codeshelf/CHECON.MECH/README.md

# CHECON.MECH
The mechanicals for the CHE controller
