codeshelf/CHECON.MECH/CHECON.MECH production files/CHECON.COVER/CHECON.COVER VER 1.1 REV B LASERCUT README.docx

CHECON.COVER VER 1.1 REV B LASERCUT README

For PONOKO

use file - P2X24 CHECON.COVER VER 1.1 REV B PRODUCTION.eps

material - CLEAR ACRYLIC

thickness - 0.118 inches

sheet size - p2

yield - 24
