codeshelf/CHECON.MECH/CHECON.MECH production files/CHECON.TRAY/CHECON.TRAY LASERCUT README VER 1.0 REV A.docx

CHECON.TRAY VER 1.0 REV A LASERCUT README

For PONOKO

use file - P2X24 CHECON.TRAY VER 1.0 REV A PRODUCTION.eps

material - CLEAR ACRYLIC

thickness - 0.060 inches

sheet size - p2

yield - 24
