codeshelf/CHECON.MECH/CHECON.MECH.BOM.xlsx

 | Product Name: | CHE Controller Mechanicals |  | Tag: | CHECON.MECH.v1.5 RC
 | Product Number: | CHECON.MECH |  | Date: | 2015-08-03
 |  |  |  | Last Updated: | 2015-08-03
Qty | Name | Description | Drawing/Part No. | Version | Date | Supplier | Link | Notes
1 | Top Coverplate | Machined Aluminum Part | CHECON.FACE | VER 1.1 REV B |  | Mean Machine Inc.
1 | Screen Coverplate Top | Lasercut Acrylic Screen Cover | CHECON.COVER | VER 1.1 REV B |  | Ponoko
1 | Screen Coverplate Bottom | Lasercut Acrylic Screen alignment tray | CHECON.TRAY | VER 1.0 REV A |  | Ponoko
1 | Zero Screw Core | Lasercut and/or Machined Delrin Part | CHECON.CORETOP | VER 1.0 REV A |  | Mean Machine Inc.
1 | Four Screw Core B | Delrin Shell Part, Top | CHECON.COREMID | VER 1.1 REV B |  | Mean Machine Inc.
1 | Four Screw Core A | Delrin Shell Part, Bottom | CHECON.COREBOT | VER 1.1 REV B |  | Mean Machine Inc.
1 | Bottom Coverplate | Lasercut 6061 1/16" Aluminum Sheet | CHECON.BACK | VER 1.1 REV B |  | Mean Machine Inc.
2 | PEM Cold-Pressed Stud | McMaster PN 93580A220 18-8 SS, 6-32 thread, 0.5" long | 93580A220 |  |  | McMaster-Carr | http://www.mcmaster.com/#catalog/121/3178/=x1v7sd
n/a | Delrin (acetal resin), black, 0.25” thick | Feedstock
n/a | 6061 Aluminum sheet, 1/16” thick | Feedstock
n/a | Clear Acrylic, 0.060” thick | Feedstock
n/a | Clear Acrylic, 0.118” thick | Feedstock
