codeshelf/CHECON.MECH/CHECON.MECH design files/CHECON.MECH packngo/S181FL-6-RMM-2450S.SLDASM

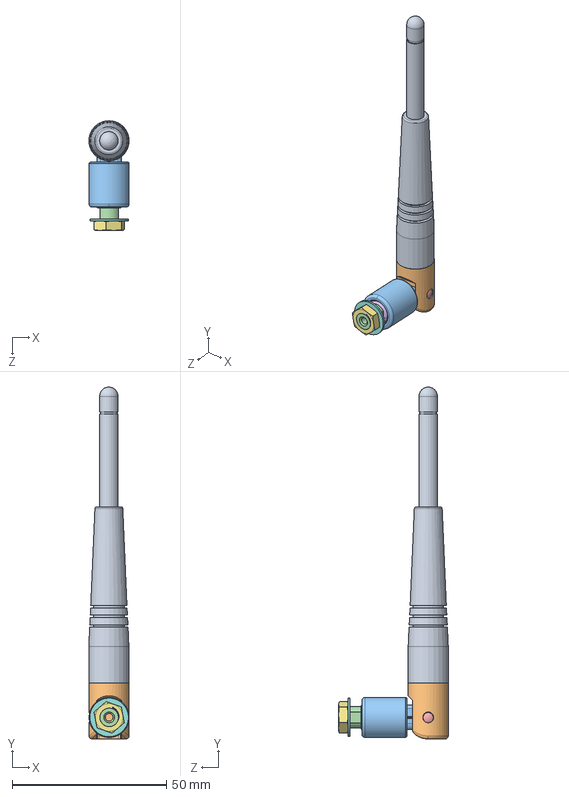
[picture p1: CAD file, 2015-04-10]
CHECON.MECH design files/CHECON.MECH packngo/S181FL-6-RMM-2450S.SLDASM
13.1 x 114.0 x 35.5 mm
03075B0000_REV.04_IW-144&151¤U©T©w®y
01391B0001(REV.01)
01257B0000-³s±µ¤l(IW-144)(REV03) x 2
09010B0000
01375N0000
02021Z0001
