codeshelf/CHECON.MECH/CHECON.MECH design files/CHECON.MECH packngo/CHE Backplate Assy.sldasm

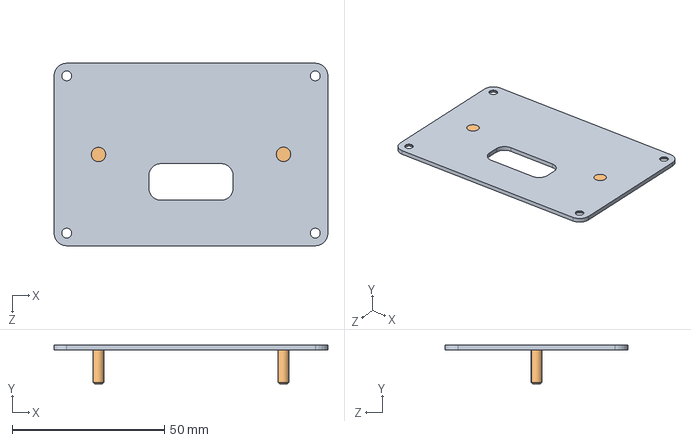
[picture p2: CAD file, 2015-04-10]
CHECON.MECH design files/CHECON.MECH packngo/CHE Backplate Assy.sldasm
90.0 x 12.7 x 60.0 mm
CHE Backplate
