codeshelf/CHECON.MECH/CHECON.MECH design files/CHECON.MECH packngo/CHECON.MECH full assembly.SLDASM

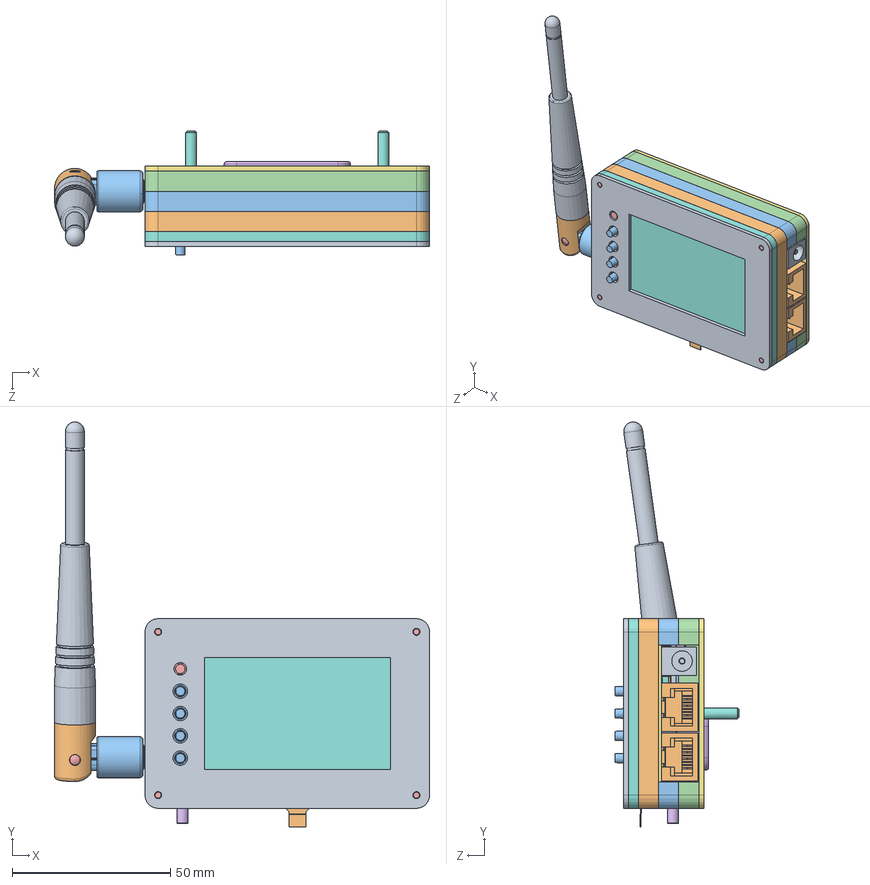
[picture p3: CAD file, 2015-04-10]
CHECON.MECH design files/CHECON.MECH packngo/CHECON.MECH full assembly.SLDASM
118.6 x 128.1 x 39.2 mm
CHE Coverplate
CHE 0 Screw Core
CHE 4 Screw Core Quarter Inch B
CHE 4 Screw Core Quarter Inch A
91771A115 x 4
heyco-2968
CHE Backplate
BrainPCB
DF12(3.0)-40DS-0.5V_1
Part1^03 BrainPCBAssembly
MMCX_Connector
93135A275 x 2
94900A005
02 CHEDaughterPCB
DF12(3.0)-40DP-0.5V
PJ-002A_Barrel
955016889_RJ45 x 2
TL3301DFxxxxG-13mm x 4
AAA3528
VLP-400-F
c-2-1825027-0-g1-3d_RA_Button
JTAG Header
Screen Coverplate Top Rev. B
Screen Coverplate Bottom
Rear POL
Front POL
LCD glass
Screen Spacer
03075B0000_REV.04_IW-144&151¤U©T©w®y
01391B0001(REV.01)
01257B0000-³s±µ¤l(IW-144)(REV03) x 2
09010B0000
01375N0000
02021Z0001
