codeshelf/CHECON.MECH/CHECON.MECH design files/CHECON.MECH packngo/02 LEDElectronicsAssembly.SLDASM

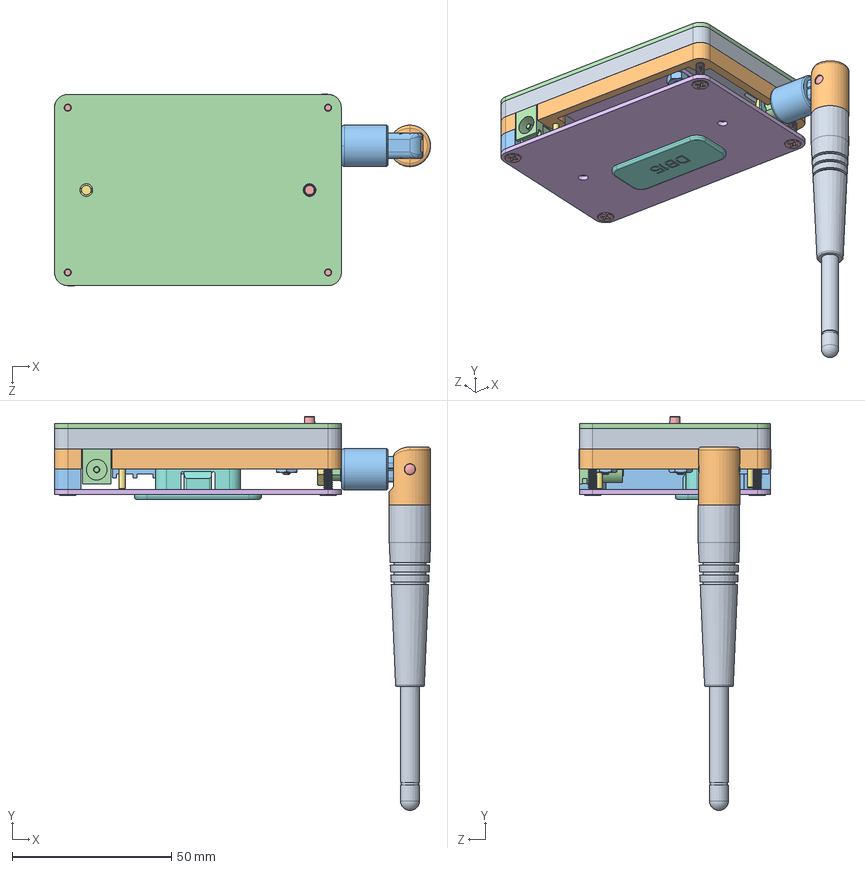
[picture p4: CAD file, 2015-04-10]
CHECON.MECH design files/CHECON.MECH packngo/02 LEDElectronicsAssembly.SLDASM
118.0 x 123.6 x 60.1 mm
02.1 LEDDaughterPCB
DF12(3.0)-40DP-0.5V
c-0350944-10-n-3d_Mate-n-lok
PJ-002A_Barrel
TL3301PFxxxxG_Button
AAA3528
VLP-200-F
91735A145 x 2
90480A007 x 2
93135A275 x 2
94900A005 x 2
JTAG Header
MMCX_Connector
BrainPCB
DF12(3.0)-40DS-0.5V_1
Part1^03 BrainPCBAssembly
LED 0 Screw Core
LED 4 Screw Core Quarter Inch B
LEDCON.CORESIDE
Top Coverplate
Flat Head Machine Screw Seven Eights x 4
00 LED Bottom Coverplate
93600A082 Dowel Pin 2mmx18mm x 2
heyco-2968
03075B0000_REV.04_IW-144&151¤U©T©w®y
01391B0001(REV.01)
01257B0000-³s±µ¤l(IW-144)(REV03) x 2
09010B0000
01375N0000
02021Z0001
