codeshelf/CHECON.MECH/CHECON.MECH design files/CHECON.MECH packngo/Daughter to Brain Connector DF12(3.0)-40DS-0.5V.SLDASM

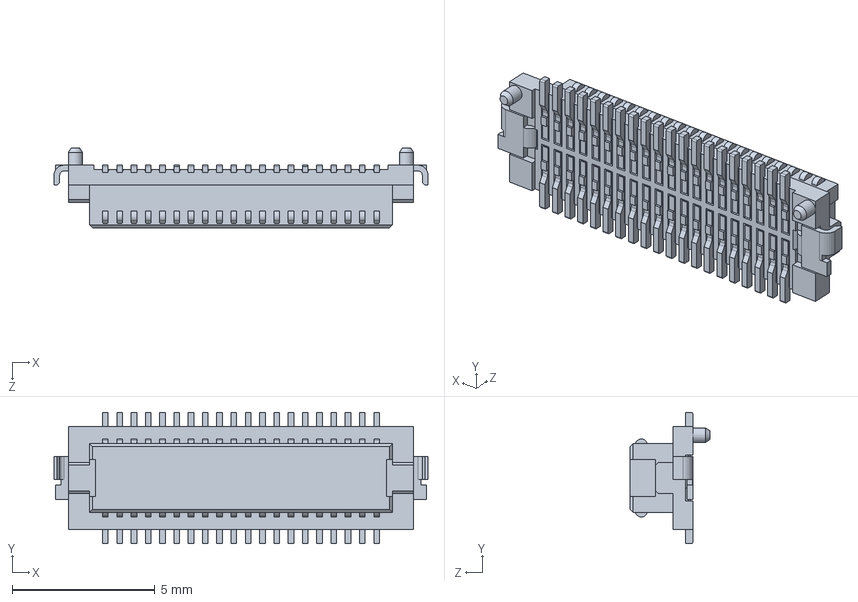
[picture p5: CAD file, 2015-04-10]
CHECON.MECH design files/CHECON.MECH packngo/Daughter to Brain Connector DF12(3.0)-40DS-0.5V.SLDASM
13.1 x 4.60 x 2.80 mm
