codeshelf/CHECON.MECH/CHECON.MECH production files/CHECON.COREBOT/CHECON.COREBOT VER 1.1 REV B.STEP

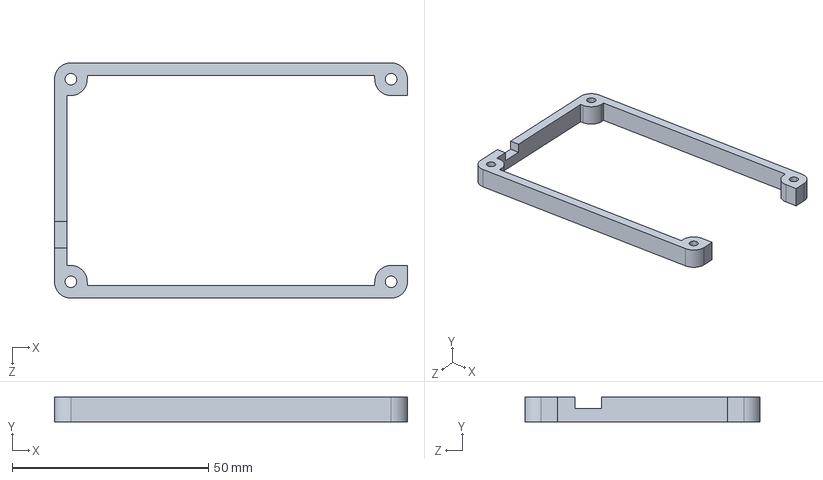
[picture p6: CAD file, 2015-07-16]
CHECON.MECH production files/CHECON.COREBOT/CHECON.COREBOT VER 1.1 REV B.STEP
90.0 x 6.35 x 60.0 mm
