codeshelf/CHECON.MECH/CHECON.MECH production files/CHECON.CORETOP/CHECON.CORETOP VER 1.0 REV A.STEP

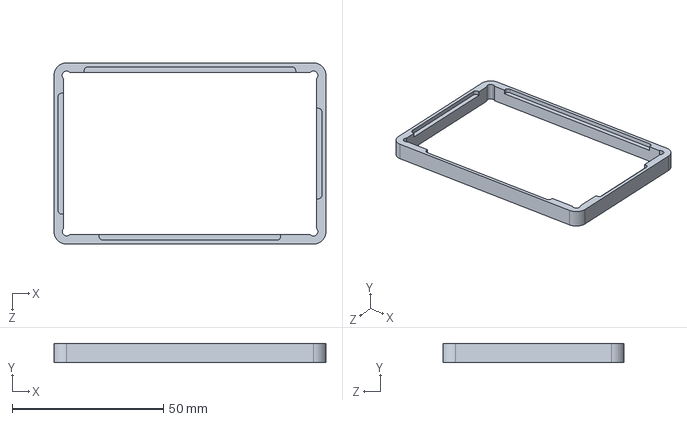
[picture p7: CAD file, 2015-04-10]
CHECON.MECH production files/CHECON.CORETOP/CHECON.CORETOP VER 1.0 REV A.STEP
90.0 x 6.35 x 60.0 mm
