codeshelf/CHECON.MECH/CHECON.MECH production files/CHECON.FACE/CHECON.FACE VER 1.1 REV B.STEP

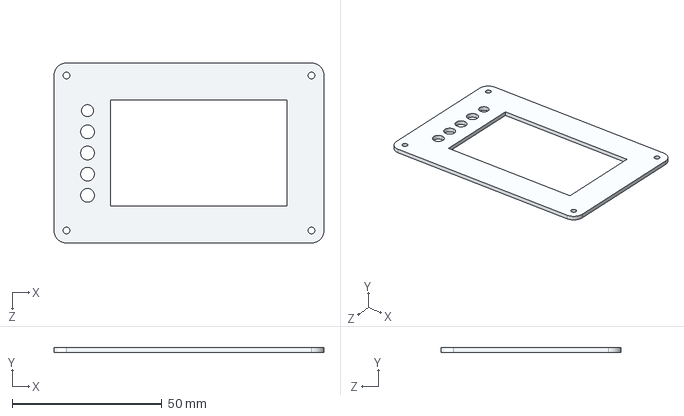
[picture p8: CAD file, 2015-04-10]
CHECON.MECH production files/CHECON.FACE/CHECON.FACE VER 1.1 REV B.STEP
90.0 x 1.59 x 60.0 mm
