codeshelf/CHECON.MECH/CHECON.MECH design files/CHECON.MECH packngo/TL3301DFxxxxG-13mm.SLDPRT

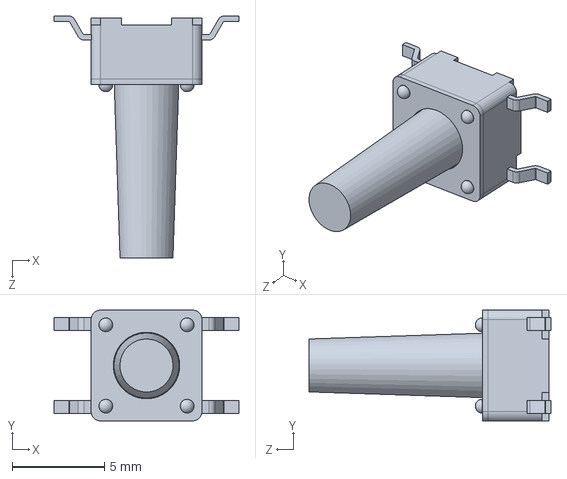
[picture p9: CAD file, 2015-04-10]
CHECON.MECH design files/CHECON.MECH packngo/TL3301DFxxxxG-13mm.SLDPRT
10.0 x 6.00 x 13.1 mm
