codeshelf/CHECON.MECH/CHECON.MECH design files/CHECON.MECH packngo/Screen Coverplate Top Rev. B.SLDPRT

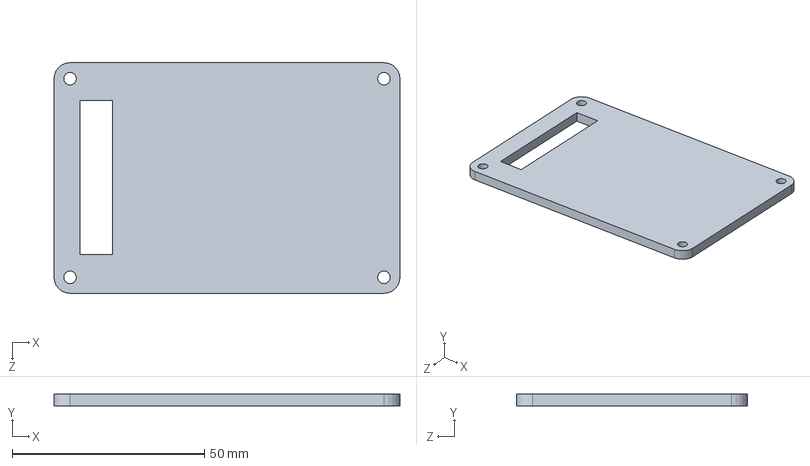
[picture p10: CAD file, 2015-04-10]
CHECON.MECH design files/CHECON.MECH packngo/Screen Coverplate Top Rev. B.SLDPRT
90.0 x 3.17 x 60.0 mm
