codeshelf/CHECON.MECH/CHECON.MECH design files/CHECON.MECH packngo/MMCX_Connector.SLDPRT

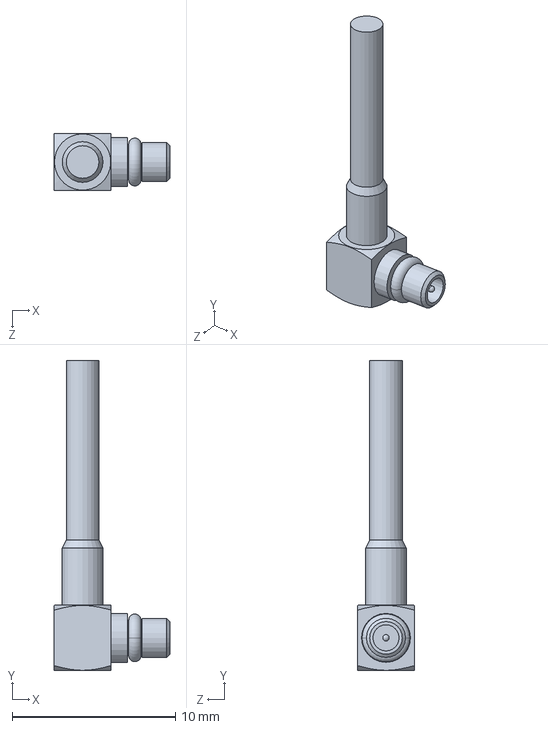
[picture p11: CAD file, 2015-04-10]
CHECON.MECH design files/CHECON.MECH packngo/MMCX_Connector.SLDPRT
7.10 x 19.0 x 3.50 mm
