codeshelf/CHECON.MECH/CHECON.MECH design files/CHECON.MECH packngo/Screen Coverplate Bottom.SLDPRT

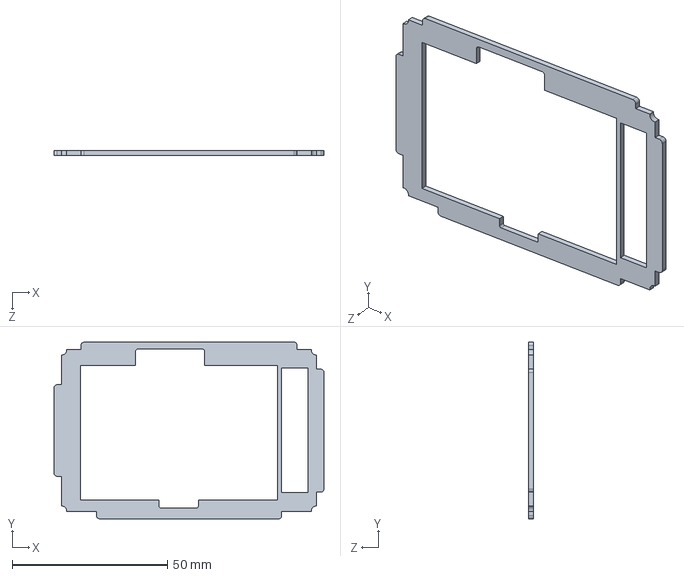
[picture p12: CAD file, 2015-04-10]
CHECON.MECH design files/CHECON.MECH packngo/Screen Coverplate Bottom.SLDPRT
86.8 x 56.8 x 1.59 mm
