codeshelf/CHECON.MECH/CHECON.MECH design files/CHECON.MECH packngo/DF12(3.0)-40DP-0.5V.SLDPRT

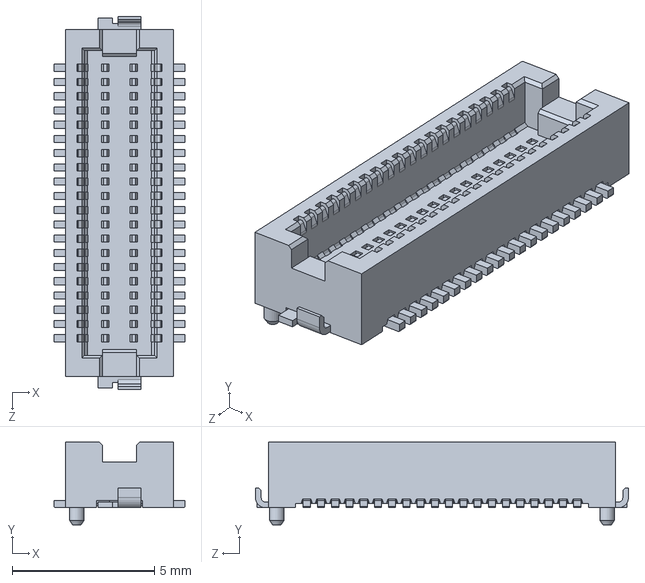
[picture p13: CAD file, 2015-04-10]
CHECON.MECH design files/CHECON.MECH packngo/DF12(3.0)-40DP-0.5V.SLDPRT
4.60 x 2.90 x 13.1 mm
