codeshelf/CHECON.MECH/CHECON.MECH design files/CHECON.MECH packngo/JTAG Header.SLDPRT

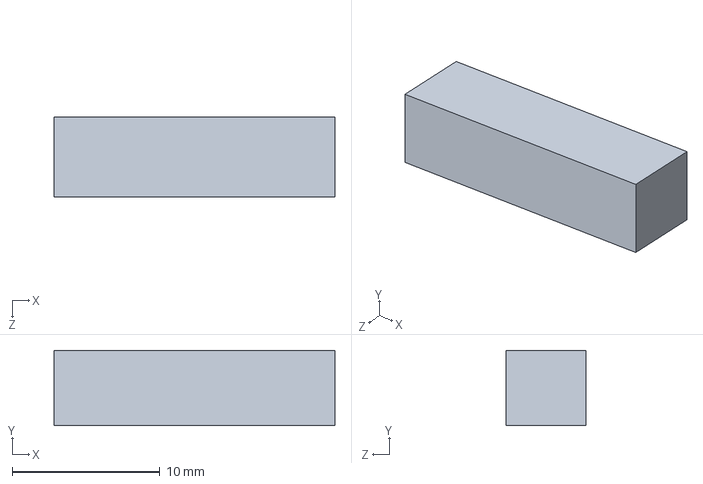
[picture p14: CAD file, 2015-04-10]
CHECON.MECH design files/CHECON.MECH packngo/JTAG Header.SLDPRT
19.0 x 5.10 x 5.40 mm
