codeshelf/CHECON.MECH/CHECON.MECH design files/CHECON.MECH packngo/c-2-1825027-0-g1-3d_RA_Button.SLDPRT

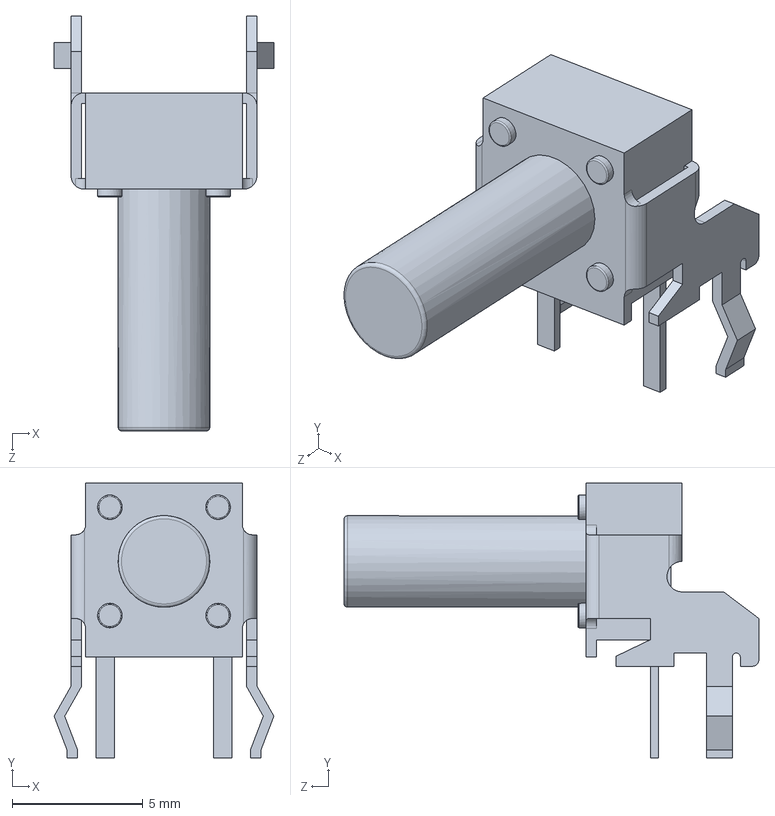
[picture p15: CAD file, 2015-04-10]
CHECON.MECH design files/CHECON.MECH packngo/c-2-1825027-0-g1-3d_RA_Button.SLDPRT
8.41 x 10.5 x 15.9 mm
