codeshelf/CHECON.MECH/CHECON.MECH design files/CHECON.MECH packngo/BrainPCB.SLDPRT

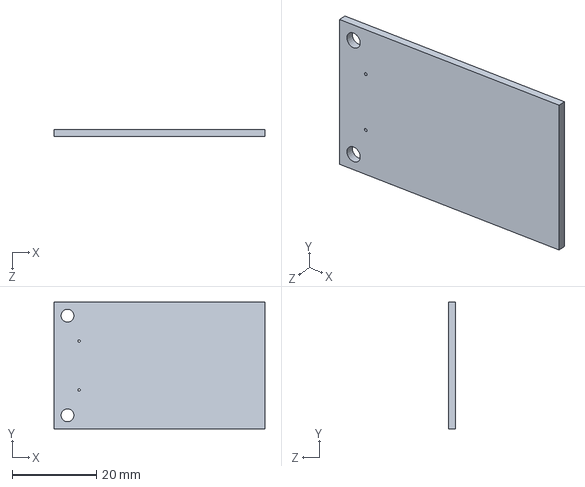
[picture p16: CAD file, 2015-04-10]
CHECON.MECH design files/CHECON.MECH packngo/BrainPCB.SLDPRT
50.0 x 30.0 x 1.58 mm
