codeshelf/CHECON.MECH/CHECON.MECH design files/CHECON.MECH packngo/02 CHEDaughterPCB.SLDPRT

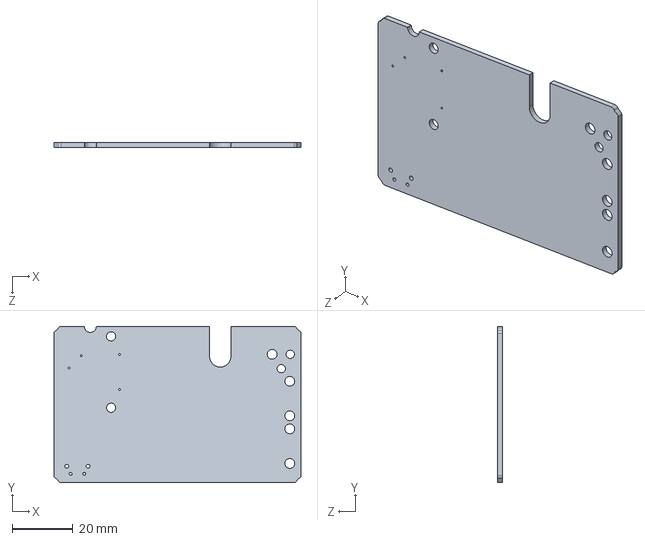
[picture p17: CAD file, 2015-04-10]
CHECON.MECH design files/CHECON.MECH packngo/02 CHEDaughterPCB.SLDPRT
81.6 x 51.6 x 1.58 mm
