codeshelf/CHECON.MECH/CHECON.MECH design files/CHECON.MECH packngo/AAA3528.sldprt

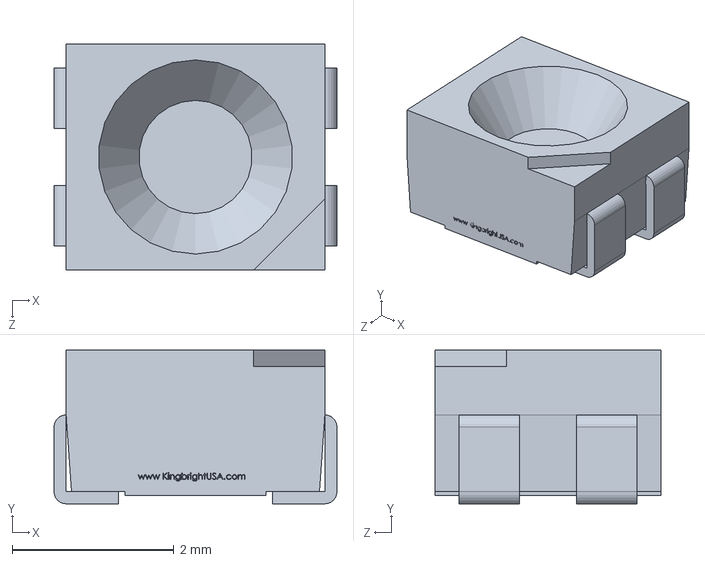
[picture p18: CAD file, 2015-04-10]
CHECON.MECH design files/CHECON.MECH packngo/AAA3528.sldprt
3.50 x 1.90 x 2.80 mm
