codeshelf/CHECON.MECH/CHECON.MECH design files/CHECON.MECH packngo/PJ-002A_Barrel.SLDPRT

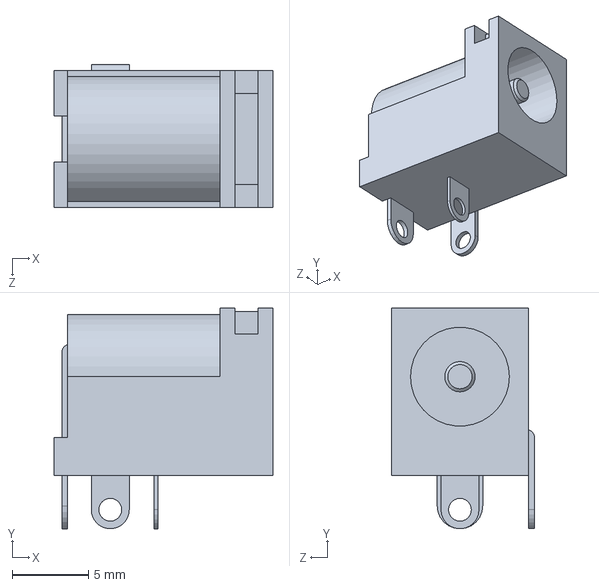
[picture p19: CAD file, 2015-04-10]
CHECON.MECH design files/CHECON.MECH packngo/PJ-002A_Barrel.SLDPRT
14.4 x 14.5 x 9.40 mm
