codeshelf/CHECON.MECH/CHECON.MECH design files/CHECON.MECH packngo/CHE Backplate.SLDPRT

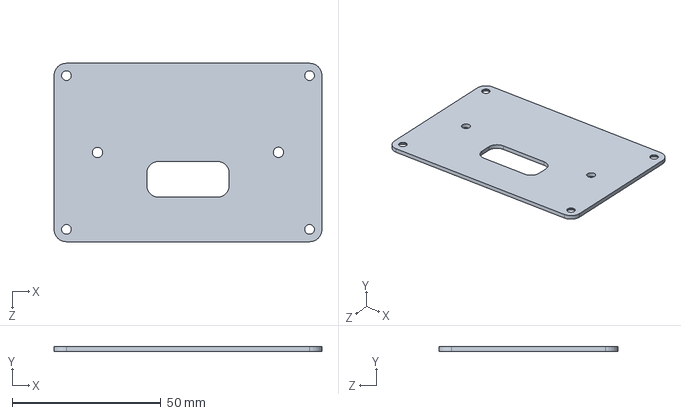
[picture p20: CAD file, 2015-04-10]
CHECON.MECH design files/CHECON.MECH packngo/CHE Backplate.SLDPRT
90.0 x 1.59 x 60.0 mm
