codeshelf/CHECON.MECH/CHECON.MECH design files/CHECON.MECH packngo/heyco-2968.SLDPRT

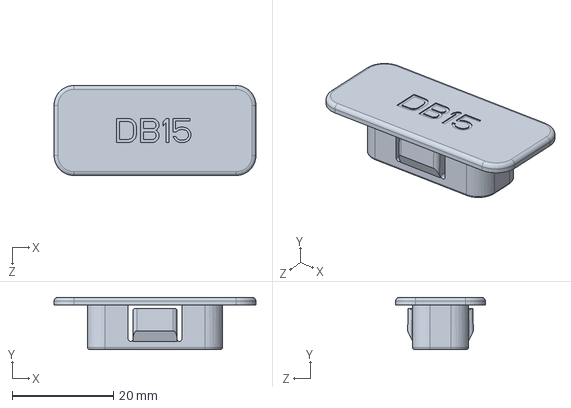
[picture p21: CAD file, 2015-04-10]
CHECON.MECH design files/CHECON.MECH packngo/heyco-2968.SLDPRT
39.9 x 10.3 x 17.8 mm
