codeshelf/CHECON.MECH/CHECON.MECH design files/CHECON.MECH packngo/VLP-400-F.SLDPRT

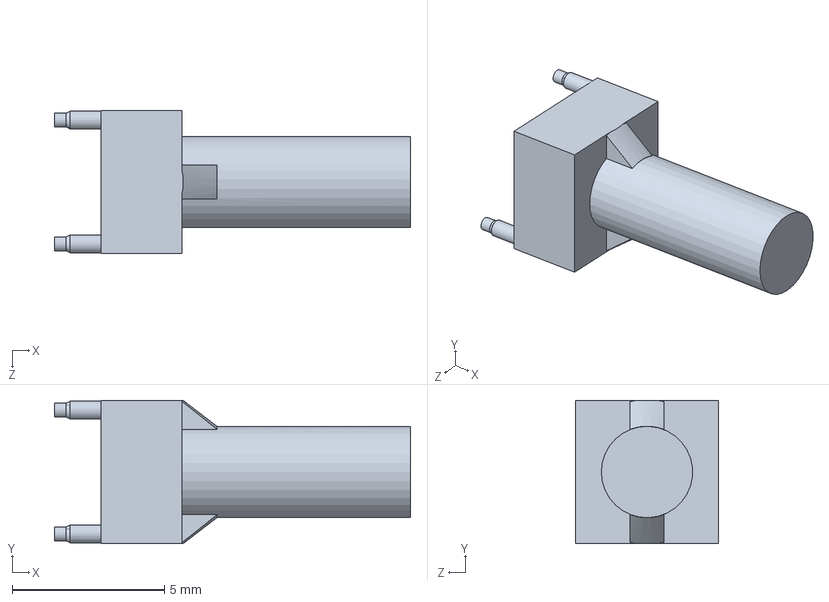
[picture p22: CAD file, 2015-04-10]
CHECON.MECH design files/CHECON.MECH packngo/VLP-400-F.SLDPRT
11.7 x 4.70 x 4.70 mm
