codeshelf/CHECON.MECH/CHECON.MECH design files/CHECON.MECH packngo/Front POL.sldprt

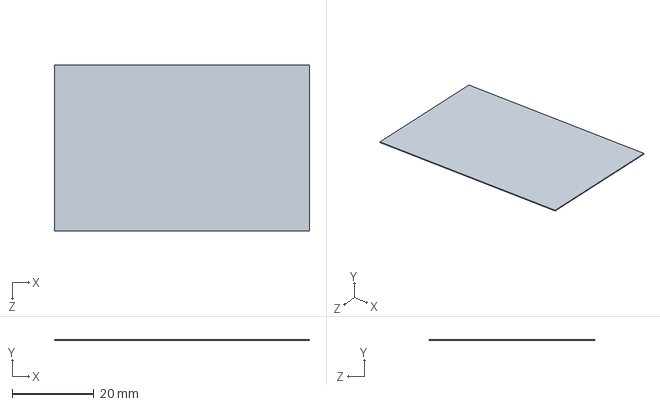
[picture p23: CAD file, 2015-04-10]
CHECON.MECH design files/CHECON.MECH packngo/Front POL.sldprt
62.2 x 0.226 x 40.4 mm
