codeshelf/CHECON.MECH/CHECON.MECH design files/CHECON.MECH packngo/03 BrainPCBAssembly.SLDASM

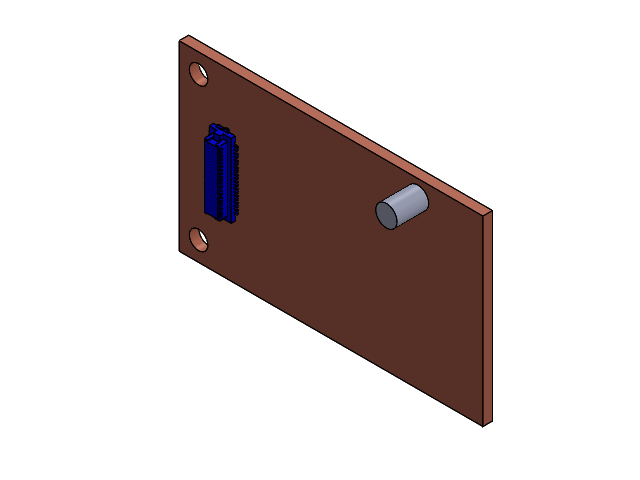
[picture p24: CAD file, 2015-04-10]
CHECON.MECH design files/CHECON.MECH packngo/03 BrainPCBAssembly.SLDASM
BrainPCB
DF12(3.0)-40DS-0.5V_1
Part1^03 BrainPCBAssembly
