codeshelf/CHECON.MECH/(list of files, cad)

Other CAD files:
CHECON.MECH design files/CHECON.MECH packngo/Assembly-1_1.sldasm
CHECON.MECH design files/CHECON.MECH packngo/DF12(3.0)-40DS-0.5V_1.sldprt
CHECON.MECH production files/CHECON.BACK/CHECON.BACK VER 1.1 REV B.STEP
CHECON.MECH production files/CHECON.COREMID/CHECON.COREMID VER 1.1 REV B.STEP
CHECON.MECH design files/CHECON.MECH packngo/Screen Spacer.sldprt
CHECON.MECH design files/CHECON.MECH packngo/CHE Coverplate.SLDPRT
CHECON.MECH design files/CHECON.MECH packngo/Rear POL.sldprt
CHECON.MECH design files/CHECON.MECH packngo/JTAG Header Plug alignment.sldprt
CHECON.MECH design files/CHECON.MECH packngo/-FPC.sldprt
CHECON.MECH design files/CHECON.MECH packngo/LCD glass.sldprt
CHECON.MECH design files/CHECON.MECH packngo/01257B0000-³s±µ¤l(IW-144)(REV03).sldprt
CHECON.MECH design files/CHECON.MECH packngo/01375N0000.sldprt
CHECON.MECH design files/CHECON.MECH packngo/01391B0001(REV.01).sldprt
CHECON.MECH design files/CHECON.MECH packngo/02021Z0001.sldprt
CHECON.MECH design files/CHECON.MECH packngo/03073.sldprt
CHECON.MECH design files/CHECON.MECH packngo/03074.sldprt
CHECON.MECH design files/CHECON.MECH packngo/03075B0000_REV.04_IW-144&151¤U©T©w®y.sldprt
CHECON.MECH design files/CHECON.MECH packngo/09010B0000.sldprt
CHECON.MECH design files/CHECON.MECH packngo/1190500000000-1136_REV.01_MMCX(m),Crimp,90«×,RG178(§tCABLE&¼öÁY).sldprt
CHECON.MECH design files/CHECON.MECH packngo/20121115_LS027B7DH01_3D.SLDASM
CHECON.MECH design files/CHECON.MECH packngo/20150116-173346-99358161.SLDPRT
CHECON.MECH design files/CHECON.MECH packngo/527451097.SLDPRT
CHECON.MECH design files/CHECON.MECH packngo/91771A115.SLDPRT
CHECON.MECH design files/CHECON.MECH packngo/93135A275.SLDPRT
CHECON.MECH design files/CHECON.MECH packngo/94900A005.SLDPRT
CHECON.MECH design files/CHECON.MECH packngo/955016889_RJ45.SLDPRT
CHECON.MECH design files/CHECON.MECH packngo/CHE 0 Screw Core.SLDPRT
CHECON.MECH design files/CHECON.MECH packngo/CHE 4 Screw Core Quarter Inch A.SLDPRT
CHECON.MECH design files/CHECON.MECH packngo/CHE 4 Screw Core Quarter Inch B.SLDPRT
CHECON.MECH design files/CHECON.MECH packngo/FPC.sldprt
CHECON.MECH production files/CHECON.BACK/CHECON.BACK VER 1.1 REV B.SLDPRT
CHECON.MECH production files/CHECON.COREBOT/CHECON.COREBOT VER 1.1 REV B.SLDPRT
CHECON.MECH production files/CHECON.COREMID/CHECON.COREMID VER 1.1 REV B.SLDPRT
CHECON.MECH production files/CHECON.CORETOP/CHECON.CORETOP VER 1.0 REV A.SLDPRT
CHECON.MECH production files/CHECON.FACE/CHECON.FACE VER 1.1 REV B.SLDPRT
