codeshelf/CHECON.MECH/CHECON.MECH production files/CHECON.COREBOT/CHECON.COREBOT VER 1.1 REV B.pdf

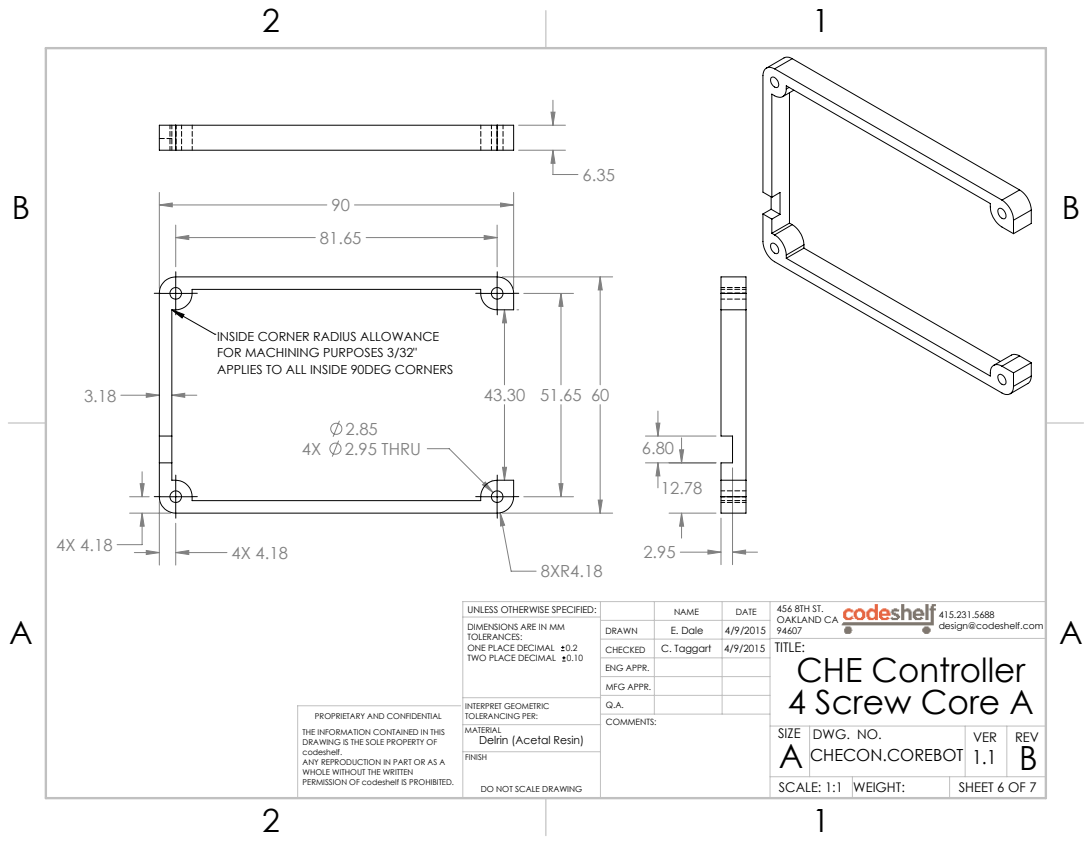
[picture p25: page 1]
4X 2.95 THRU; SHEET 6 OF 7; SCALE: 1:1; WEIGHT:; DWG. NO.; VER; INTERPRET GEOMETRIC; PROPRIETARY AND CONFIDENTIAL; TOLERANCING PER:

INSIDE CORNER RADIUS ALLOWANCE
FOR MACHINING PURPOSES 3/32"
APPLIES TO ALL INSIDE 90DEG CORNERS

UNLESS OTHERWISE SPECIFIED: | | NAME | DATE | 456 8TH ST. 415.231.5688 OAKLAND CA design@codeshelf.com 94607
TOLERANCES: ONE PLACE DECIMAL 0.2 TWO PLACE DECIMAL 0.10 | DRAWN | E. Dale | 4/9/2015 DIMENSIONS ARE IN MM

CHECKED | C. Taggart | 4/9/2015 | TITLE: CHE Controller 4 Screw Core A

ENG APPR.
MFG APPR.

THE INFORMATION CONTAINED IN THIS
DRAWING IS THE SOLE PROPERTY OF
codeshelf.
ANY REPRODUCTION IN PART OR AS A
WHOLE WITHOUT THE WRITTEN
PERMISSION OF codeshelf IS PROHIBITED.

MATERIAL
Delrin (Acetal Resin)
FINISH

DO NOT SCALE DRAWING
