codeshelf/CHECON.MECH/CHECON.MECH production files/CHECON.BACK/CHECON.BACK VER 1.1 REV B.PDF

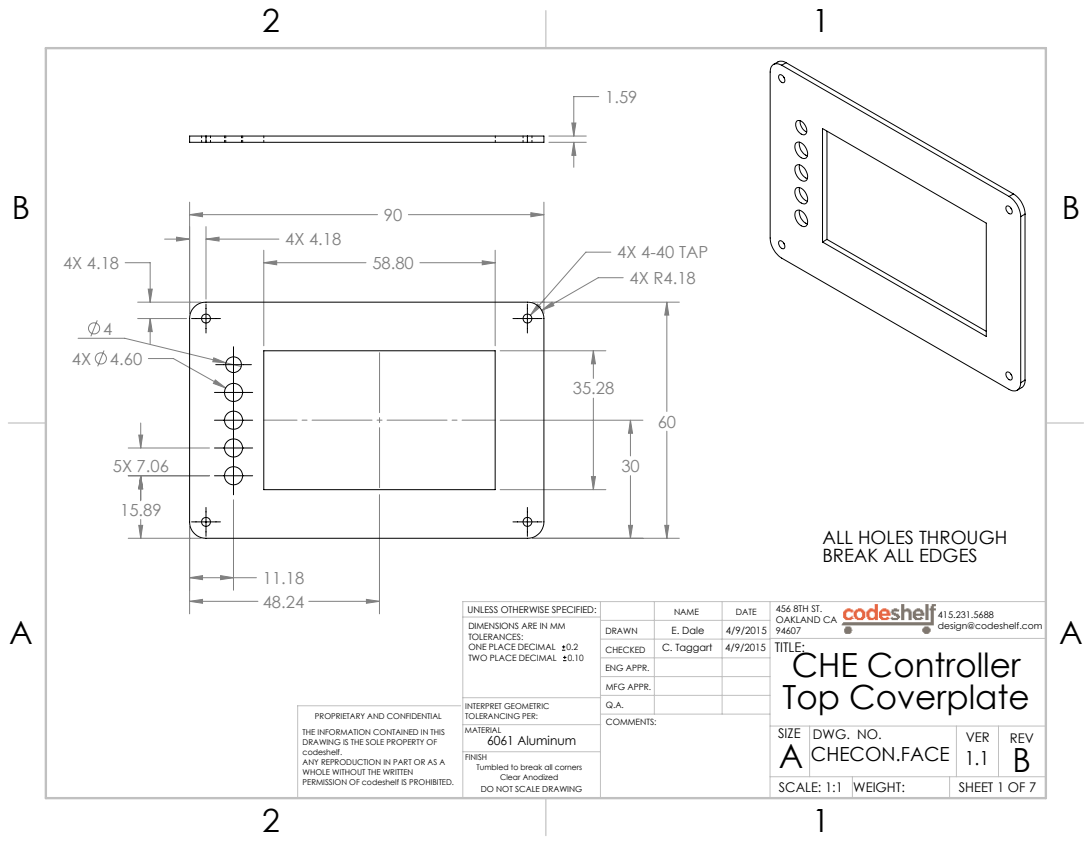
[picture p26: page 1]
4X 4-40 TAP 4X R4.18; SHEET 1 OF 7; SCALE: 1:1; WEIGHT:; DWG. NO.; VER

ALL HOLES THROUGH
BREAK ALL EDGES

UNLESS OTHERWISE SPECIFIED: | | NAME | DATE | 456 8TH ST. 415.231.5688 OAKLAND CA design@codeshelf.com 94607
DIMENSIONS ARE IN MM TOLERANCES: ONE PLACE DECIMAL 0.2 TWO PLACE DECIMAL 0.10 | DRAWN | E. Dale | 4/9/2015
CHECKED | C. Taggart | 4/9/2015 | TITLE: CHE Controller Top Coverplate

ENG APPR.
MFG APPR.

INTERPRET GEOMETRIC TOLERANCING PER: | Q.A.

PROPRIETARY AND CONFIDENTIAL
THE INFORMATION CONTAINED IN THIS
DRAWING IS THE SOLE PROPERTY OF
codeshelf.
ANY REPRODUCTION IN PART OR AS A
WHOLE WITHOUT THE WRITTEN
PERMISSION OF codeshelf IS PROHIBITED.

MATERIAL
6061 Aluminum
FINISH
Tumbled to break all corners
Clear Anodized
DO NOT SCALE DRAWING

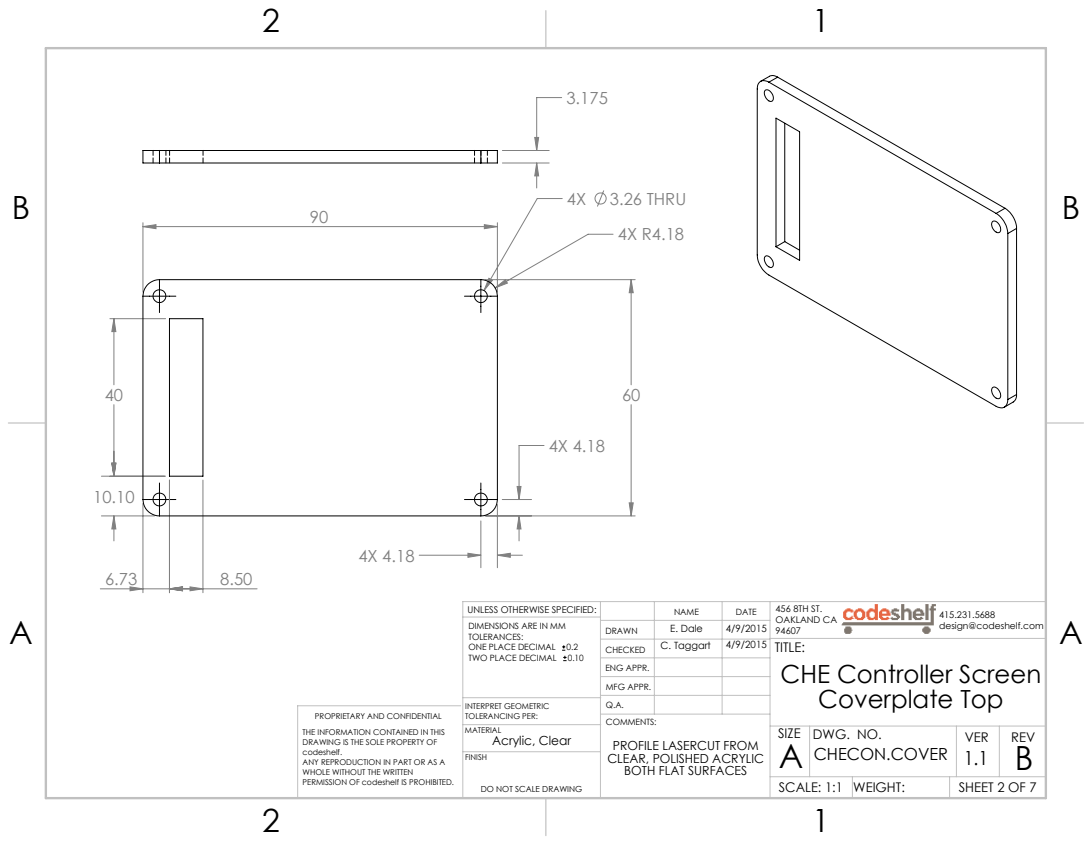
[picture p27: page 2]
4X 3.26 THRU; Acrylic, Clear; DWG. NO.; VER; INTERPRET GEOMETRIC; PROPRIETARY AND CONFIDENTIAL; TOLERANCING PER:

UNLESS OTHERWISE SPECIFIED: | | NAME | DATE | 456 8TH ST. 415.231.5688 OAKLAND CA design@codeshelf.com 94607
DIMENSIONS ARE IN MM ONE PLACE DECIMAL 0.2 TWO PLACE DECIMAL 0.10 | DRAWN | E. Dale | 4/9/2015 TOLERANCES:

CHECKED | C. Taggart | 4/9/2015 | TITLE: CHE Controller Screen Coverplate Top

ENG APPR.
MFG APPR.

COMMENTS:
PROFILE LASERCUT FROM
CLEAR, POLISHED ACRYLIC
BOTH FLAT SURFACES

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

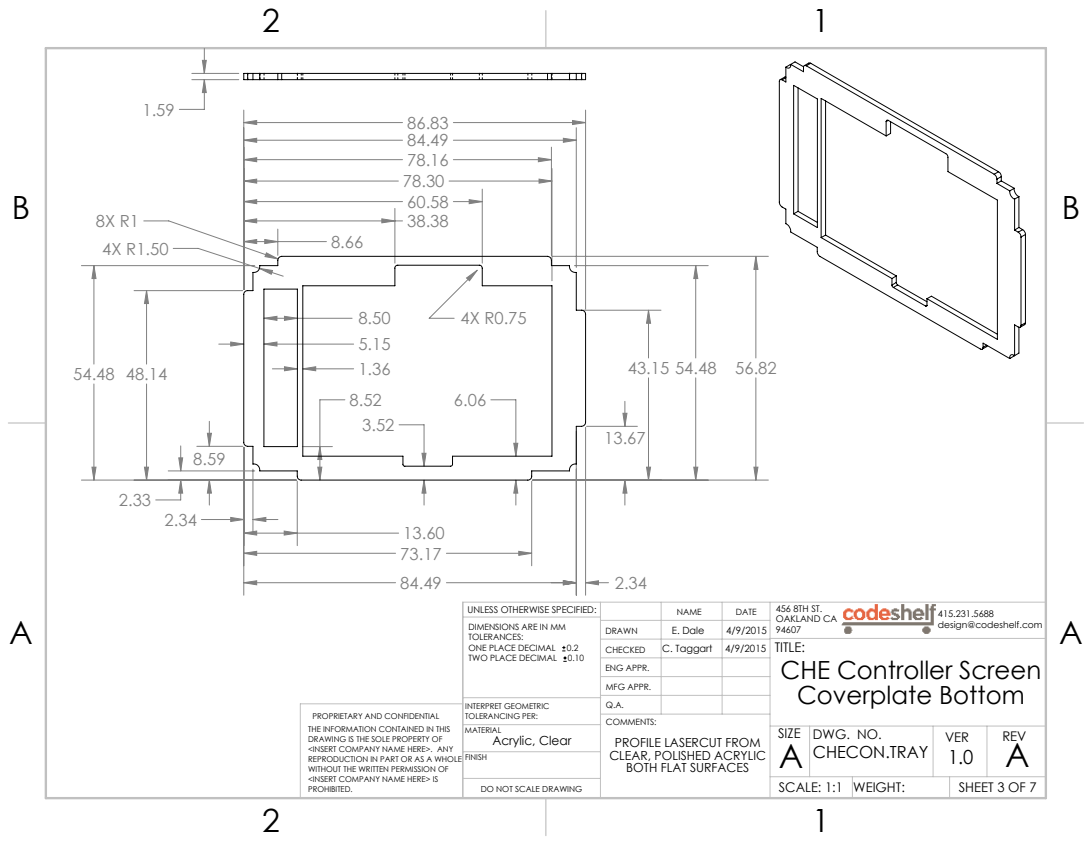
[picture p28: page 3]
Acrylic, Clear; DWG. NO.; VER; INTERPRET GEOMETRIC; PROPRIETARY AND CONFIDENTIAL; TOLERANCING PER:

UNLESS OTHERWISE SPECIFIED: | | NAME | DATE | 456 8TH ST. 415.231.5688 OAKLAND CA design@codeshelf.com 94607
TOLERANCES: ONE PLACE DECIMAL 0.2 TWO PLACE DECIMAL 0.10 | DRAWN | E. Dale | 4/9/2015 DIMENSIONS ARE IN MM

CHECKED | C. Taggart | 4/9/2015 | TITLE: CHE Controller Screen Coverplate Bottom

ENG APPR.
MFG APPR.

COMMENTS:
PROFILE LASERCUT FROM
CLEAR, POLISHED ACRYLIC
BOTH FLAT SURFACES

THE INFORMATION CONTAINED IN THIS
DRAWING IS THE SOLE PROPERTY OF
<INSERT COMPANY NAME HERE>. ANY
REPRODUCTION IN PART OR AS A WHOLE
WITHOUT THE WRITTEN PERMISSION OF
<INSERT COMPANY NAME HERE> IS
PROHIBITED.

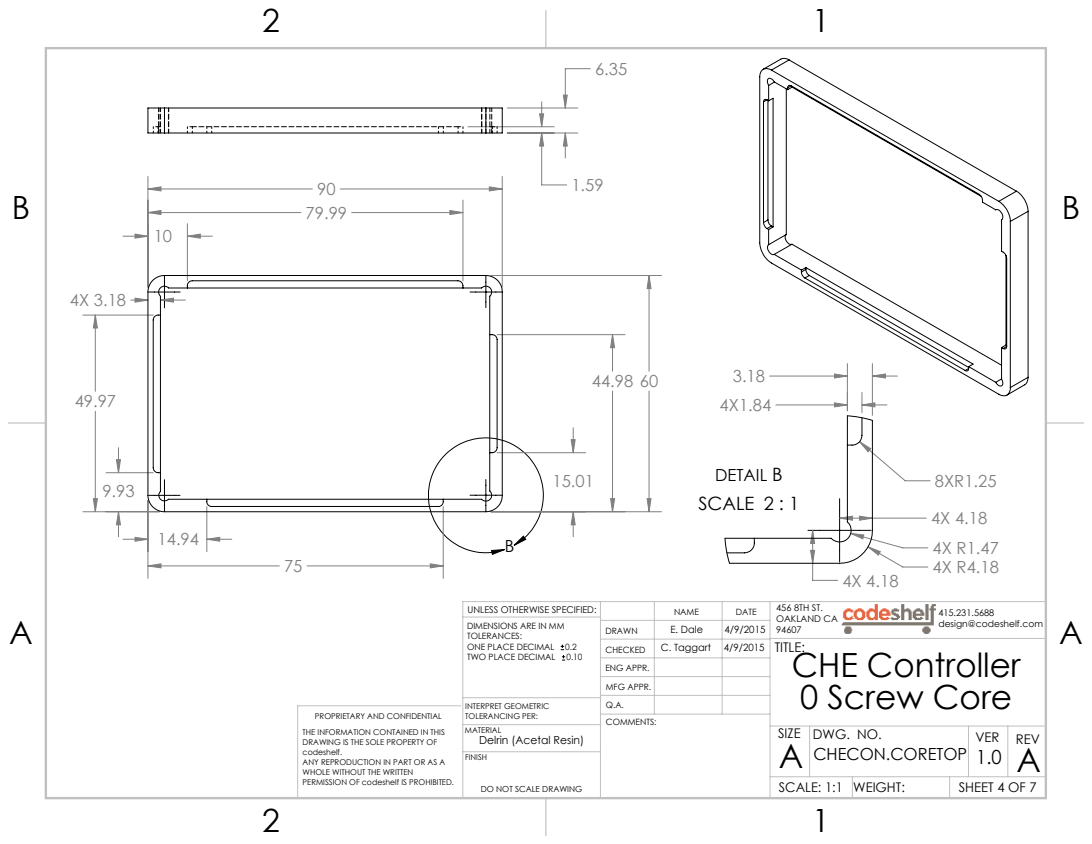
[picture p29: page 4]
DETAIL B SCALE 2 : 1; DWG. NO.; VER; INTERPRET GEOMETRIC; PROPRIETARY AND CONFIDENTIAL; TOLERANCING PER:

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

CHECKED | C. Taggart | 4/9/2015 | TITLE: CHE Controller 0 Screw Core

ENG APPR.
MFG APPR.

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

MATERIAL
Delrin (Acetal Resin)
FINISH

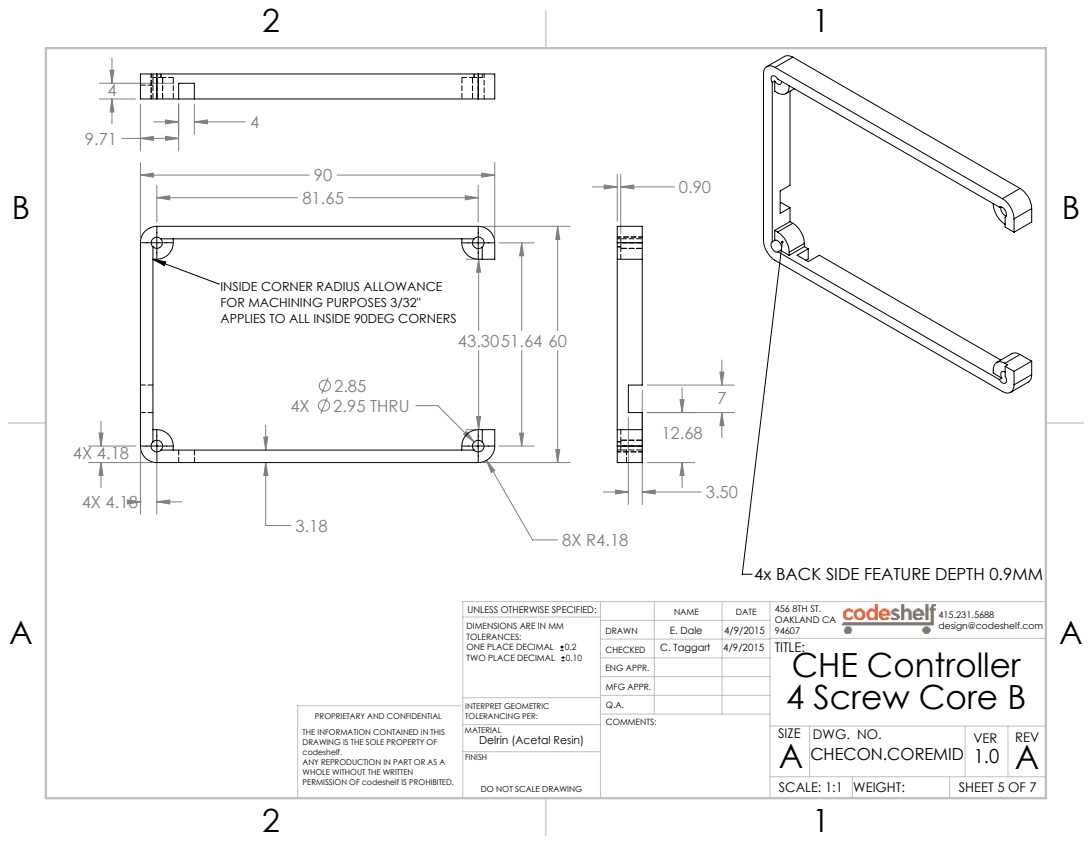
[picture p30: page 5]
4X 2.95 THRU; DWG. NO.; VER; INTERPRET GEOMETRIC; PROPRIETARY AND CONFIDENTIAL; TOLERANCING PER:

INSIDE CORNER RADIUS ALLOWANCE
FOR MACHINING PURPOSES 3/32"
APPLIES TO ALL INSIDE 90DEG CORNERS

4x BACK SIDE FEATURE DEPTH 0.9MM

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

CHECKED | C. Taggart | 4/9/2015 | TITLE: CHE Controller 4 Screw Core B

ENG APPR.
MFG APPR.

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

MATERIAL
Delrin (Acetal Resin)
FINISH

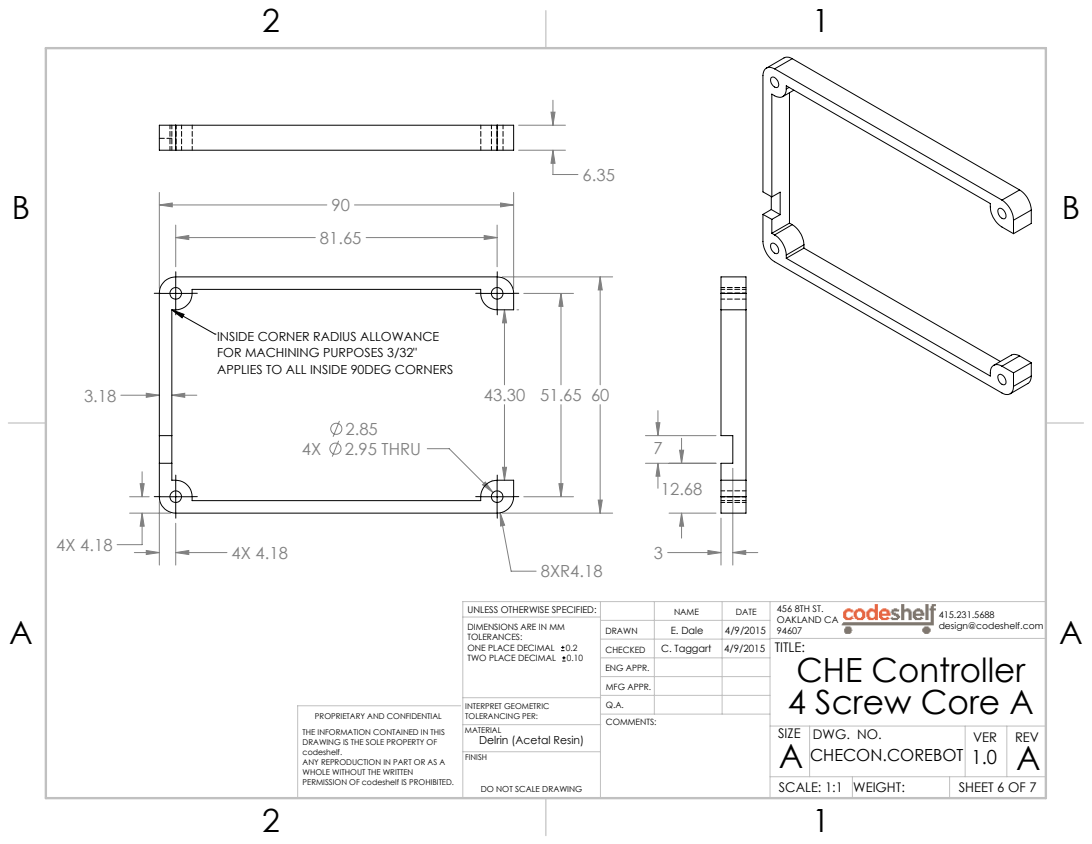
[picture p31: page 6]
4X 2.95 THRU; DWG. NO.; VER; INTERPRET GEOMETRIC; PROPRIETARY AND CONFIDENTIAL; TOLERANCING PER:

INSIDE CORNER RADIUS ALLOWANCE
FOR MACHINING PURPOSES 3/32"
APPLIES TO ALL INSIDE 90DEG CORNERS

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

CHECKED | C. Taggart | 4/9/2015 | TITLE: CHE Controller 4 Screw Core A

ENG APPR.
MFG APPR.

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

MATERIAL
Delrin (Acetal Resin)
FINISH

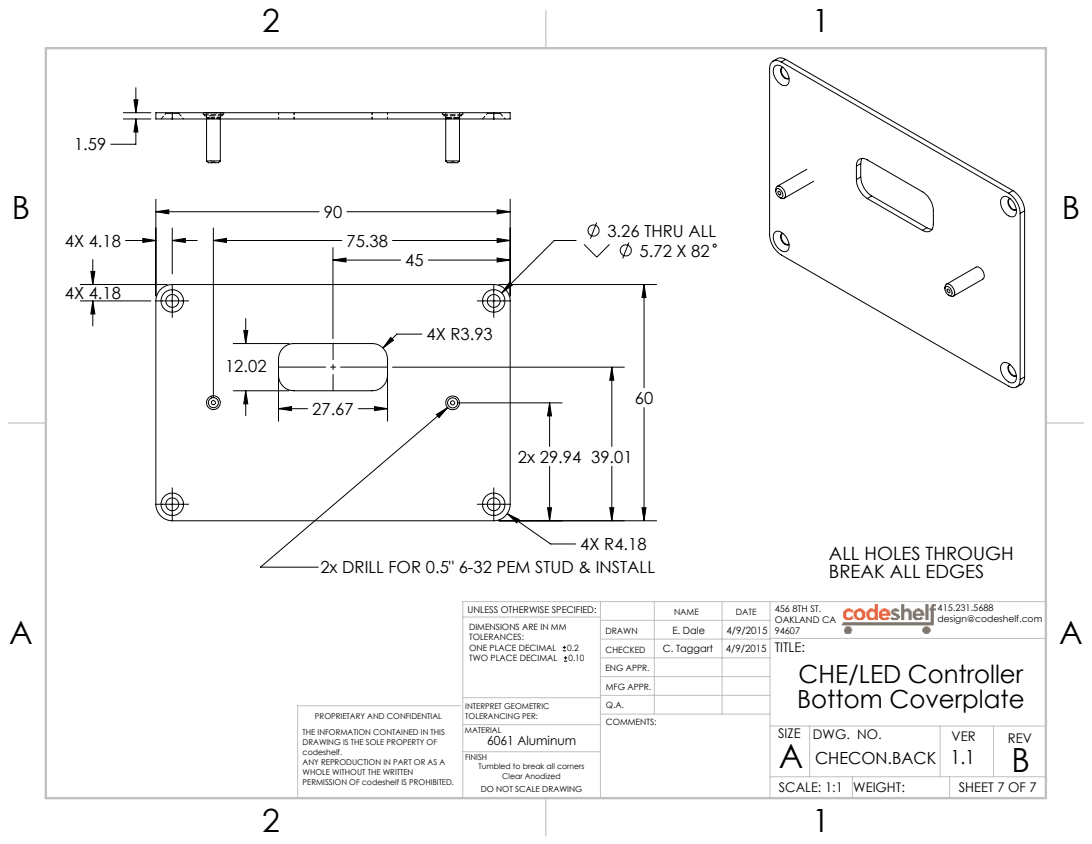
[picture p32: page 7]
3.26 THRU ALL 5.72 X 82 4X 4.18; DWG. NO.; VER; PROPRIETARY AND CONFIDENTIAL; TOLERANCING PER:

ALL HOLES THROUGH
BREAK ALL EDGES

2x DRILL FOR 0.5" 6-32 PEM STUD & INSTALL

UNLESS OTHERWISE SPECIFIED: | | NAME | DATE | 456 8TH ST. 415.231.5688 design@codeshelf.com OAKLAND CA 94607
TOLERANCES: ONE PLACE DECIMAL 0.2 TWO PLACE DECIMAL 0.10 | DRAWN | E. Dale | 4/9/2015 DIMENSIONS ARE IN MM

CHECKED | C. Taggart | 4/9/2015 | TITLE: CHE/LED Controller Bottom Coverplate

ENG APPR.
MFG APPR.

INTERPRET GEOMETRIC
6061 Aluminum
FINISH
Tumbled to break all corners
Clear Anodized

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
