codeshelf/CHECON.MECH/(commit log)

2015-04-10 CHECON v1.1 initial commit
    This is v1.1 of the CHECON.
    [-FPC.sldprt, 01257B0000-³s±µ¤l(IW-144)(REV03).sldprt, 01375N0000.sldprt, 01391B0001(REV.01).sldprt, 02 CHEDaughterPCB.SLDPRT, 02 LEDElectronicsAssembly.SLDASM, 02021Z0001.sldprt, 03 BrainPCBAssembly.SLDASM]
2015-04-13 Drawings Updated with material data
2015-04-20 Removed extra copy of ECO
    Should be in top level of .MECH
    [CHECON.MECH.ECO.xlsx]
2015-04-22 Added lasercut readme docs, edits for clarity on CHECON ECO
    [CHECON.MECH.ECO.xlsx]
2015-04-22 Aluminum parts, material change to 6061 Aluminum
    Revised CHECON.FACE and CHECON.BACK drawings to v1.1 rev B
    [CHECON.MECH.ECO.xlsx]
2015-05-05 Created BOMs for the .MECH level
    [CHECON.MECH.BOM.xlsx]
2015-05-05 Fixed numbering and dates
    [CHECON.MECH.BOM.xlsx]
2015-05-05 Added line for latests update
    [CHECON.MECH.ECO.xlsx]
2015-05-06 Fixed fonts and date
    Matching fonts
    [CHECON.MECH.BOM.xlsx, CHECON.MECH.ECO.xlsx]
2015-05-06 Formatting fixes
    [CHECON.MECH.BOM.xlsx, CHECON.MECH.ECO.xlsx]
2015-07-16 Initial commit, CHECON.MECH v1.4
    Took out a part, added a new one. Edits & updates to .MECH.BOM and
    .MECH.ECO
    [CHECON.MECH.BOM.xlsx, CHECON.MECH.ECO.xlsx]
2015-07-16 CHECON.MECH v1.4 Derivative file commit
    .SLDPRT and .STEP files for the following parts:
    CHECON.CORETOP
    CHECON.COREMID
    CHECON.COREBOT
    Also, CHECON.TRAY deleted,
    CHECON.CLIP added.
    [CHECON.CLIP.SLDPRT, CHECON.CLIP.STEP, CHECON.COREBOT.SLDPRT, CHECON.COREBOT.STEP, CHECON.COREMID.SLDPRT, CHECON.COREMID.STEP, CHECON.CORETOP.SLDPRT, CHECON.CORETOP.STEP]
2015-07-20 CHECON v1.1 initial commit production files
    [CHECON.CLIP VER 1.0 REV A.STEP, CHECON.CLIP VER 1.0 REV A.SLDPRT, CHECON.CLIP.SLDPRT, CHECON.CLIP.STEP, CHECON.COREBOT VER 1.1 REV B.SLDPRT, CHECON.COREBOT VER 1.1 REV B.STEP, CHECON.COREBOT.SLDPRT, CHECON.COREBOT.STEP]
2015-07-28 Name changes for clarity
    [CHECON.BACK VER 1.1 REV B.SLDPRT, CHECON.BACK VER 1.1 REV B.STEP, CHECON.FACE VER 1.1 REV B.SLDPRT, CHECON.FACE VER 1.1 REV B.STEP]
2015-07-28 Updated lasercut readme files to new format
2015-07-28 Edits to CHECON.MECH.ECO (copied commit messages) and CHECON.MECH.BOM (release tag and minor edit)
    [CHECON.MECH.BOM.xlsx, CHECON.MECH.ECO.xlsx]
2015-07-28 Correction to ECO of copied messages
    [CHECON.MECH.ECO.xlsx]
2015-07-28 Final edit to BOM - date correction
    [CHECON.MECH.BOM.xlsx]
2015-08-03 CHECON.MECH v1.5: Copied CHECON.TRAY v1.0 REV A and CHECON.CORETOP v1.0 REV A folders back into directory, deleted CHECON.CLIP v1.0 REV A folder
    CHECON.MECH v1.5 (Happy Antenna) reverts the CHECON.CORETOP and
    CHECON.TRAY parts, uses the revised *.COREMID and *.COREBOT parts.
    [CHECON.CLIP VER 1.0 REV A.STEP, CHECON.CLIP VER 1.0 REV A.SLDPRT, CHECON.CORETOP VER 1.1 REV B.SLDPRT, CHECON.CORETOP VER 1.1 REV B.STEP, CHECON.CORETOP.SLDPRT, CHECON.CORETOP.STEP, CHECON.MECH.BOM.xlsx]
2015-08-03 File name updates for clarity
    [CHECON.CORETOP VER 1.0 REV A.SLDPRT, CHECON.CORETOP VER 1.0 REV A.STEP]
2015-08-03 Updates to ECO for v1.5
    [CHECON.MECH.ECO.xlsx]
2015-08-03 Update lasercut README files to new format for clarity
2015-08-03 Updates to CHECON.MECH.BOM - release candidate tag & dates
    [CHECON.MECH.BOM.xlsx]
2015-08-03 Added feedstock + dimension data
    [CHECON.MECH.BOM.xlsx]
